supermileage/fuel-cell-control/README.md

# Fuel-Cell-Control
Fuel Cell Control Stuff
