supermileage/fuel-cell-control/pcb/fuel-cell-control/fuelCellControl/fuelCellControl.kicad_pcb

## KiCad design pcb/fuel-cell-control/fuelCellControl/fuelCellControl.kicad_pcb (2021-12-18)

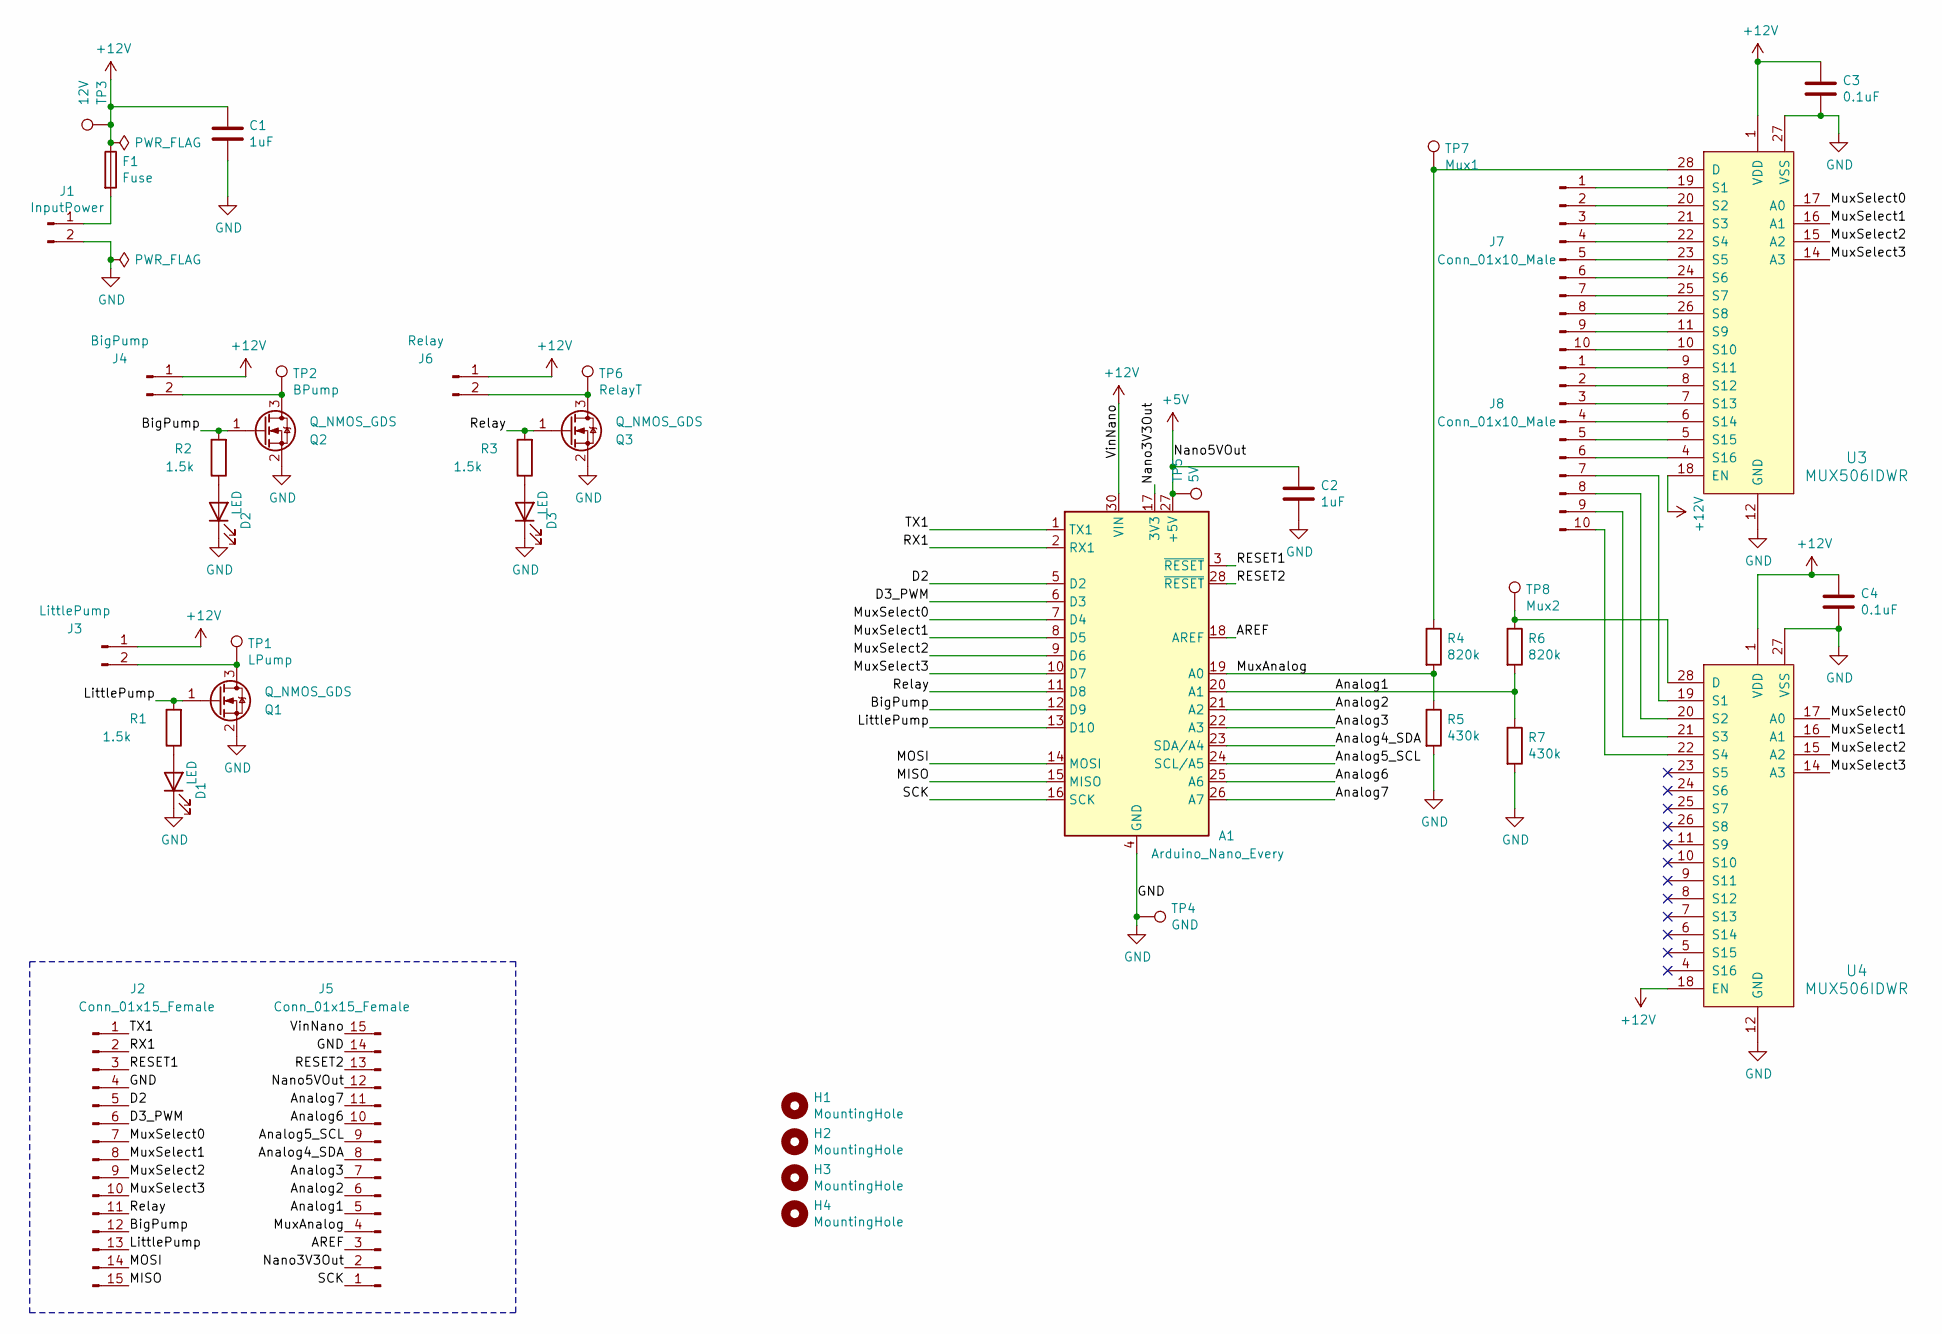
[picture p1: schematic fuelCellControl.sch]

Parts:
A1: Arduino_Nano_Every; Arduino_Nano; DigikeyPN 1050-ABX00028-ND
C1, C2: 1uF; C_0603_1608Metric; DigikeyPN 490-12330-1-ND
C3, C4: 0.1uF; C_0603_1608Metric; DigikeyPN 311-1343-1-ND
D1, D2, D3: LED; LED_0603_1608Metric; DigikeyPN SML-D12W8WT86ACT-ND
F1: Fuse; 3586KTR; DigikeyPN 36-3586KCT-ND
H1, H2, H3, H4: MountingHole; MountingHole_3.2mm_M3
J1: InputPower; Molex_Mini-Fit_Jr_5569-02A2_2x01_P4.20mm_Horizontal; DigikeyPN 0050361758-ND
J2, J5: Conn_01x15_Female; PinSocket_1x15_P2.54mm_Vertical; MPN 310-87-115-41-001101; DigikeyPN 1212-1103-ND
J3: LittlePump; Molex_Mini-Fit_Jr_5569-02A2_2x01_P4.20mm_Horizontal; DigikeyPN 0050361758-ND
J4: BigPump; Molex_Mini-Fit_Jr_5569-02A2_2x01_P4.20mm_Horizontal; DigikeyPN 0050361758-ND
J6: Relay; Molex_Mini-Fit_Jr_5569-02A2_2x01_P4.20mm_Horizontal; DigikeyPN 0050361758-ND
J7, J8: Conn_01x10_Male; PhoenixContact_MCV_1,5_10-G-3.5_1x10_P3.50mm_Vertical; DigikeyPN 277-5774-ND
Q1, Q2, Q3: Q_NMOS_GDS; SOT-89-3; DigikeyPN DMN2004WKDICT-ND
R1, R2, R3: 1.5k; R_0603_1608Metric; DigikeyPN A121524CT-ND
R4, R6: 820k; R_0603_1608Metric; DigikeyPN 311-820KHRCT-ND
R5, R7: 430k; R_0603_1608Metric; MPN RMCF0603FT430K; DigikeyPN ‎RMCF0603FT430KCT-ND‎
TP1: LPump; PinSocket_1x01_P2.54mm_Vertical
TP2: BPump; PinSocket_1x01_P2.54mm_Vertical
TP3: 12V; PinSocket_1x01_P2.54mm_Vertical
TP4: GND; PinSocket_1x01_P2.54mm_Vertical
TP5: 5V; PinSocket_1x01_P2.54mm_Vertical
TP6: RelayT; PinSocket_1x01_P2.54mm_Vertical
TP7: Mux1; PinSocket_1x01_P2.54mm_Vertical
TP8: Mux2; PinSocket_1x01_P2.54mm_Vertical
U3, U4: MUX506IDWR; SOIC-28_W7.5mm; MPN MUX506IDWR; DigikeyPN 296-47544-1-ND

Connections:
+5V: A1.27 (+5V), C2.1, J5.12, TP5.1
+12V: A1.30 (VIN), C1.1, C3.1, C4.1, F1.1, J3.1, J4.1, J5.15, J6.1, TP3.1, U3.1 (VDD), U3.18 (EN), U4.1 (VDD), U4.18 (EN)
/AREF: A1.18 (AREF), J5.3
/Analog1: A1.20 (A1), J5.5, R6.2, R7.1
/Analog2: A1.21 (A2), J5.6
/Analog3: A1.22 (A3), J5.7
/Analog4_SDA: A1.23 (SDA/A4), J5.8
/Analog5_SCL: A1.24 (SCL/A5), J5.9
/Analog6: A1.25 (A6), J5.10
/Analog7: A1.26 (A7), J5.11
/BigPump: A1.12 (D9), J2.12, Q2.1 (G), R2.2
/D2: A1.5 (D2), J2.5
/D3_PWM: A1.6 (D3), J2.6
/LittlePump: A1.13 (D10), J2.13, Q1.1 (G), R1.2
/MISO: A1.15 (MISO), J2.15
/MOSI: A1.14 (MOSI), J2.14
/MuxAnalog: A1.19 (A0), J5.4, R4.2, R5.1
/MuxSelect0: A1.7 (D4), J2.7, U3.17 (A0), U4.17 (A0)
/MuxSelect1: A1.8 (D5), J2.8, U3.16 (A1), U4.16 (A1)
/MuxSelect2: A1.9 (D6), J2.9, U3.15 (A2), U4.15 (A2)
/MuxSelect3: A1.10 (D7), J2.10, U3.14 (A3), U4.14 (A3)
/Nano3V3Out: A1.17 (3V3), J5.2
/RESET1: A1.3 (~RESET), J2.3
/RESET2: A1.28 (~RESET), J5.13
/RX1: A1.2 (RX1), J2.2
/Relay: A1.11 (D8), J2.11, Q3.1 (G), R3.2
/SCK: A1.16 (SCK), J5.1
/TX1: A1.1 (TX1), J2.1
GND: A1.4 (GND), A1.29 (GND), C1.2, C2.2, C3.2, C4.2, D1.1 (K), D2.1 (K), D3.1 (K), J1.2, J2.4, J5.14, Q1.2 (S), Q2.2 (S), Q3.2 (S), R5.2, R7.2, TP4.1, U3.12 (GND), U3.27 (VSS), U4.12 (GND), U4.27 (VSS)
unnamed: D1.2 (A), R1.1
unnamed: D2.2 (A), R2.1
unnamed: D3.2 (A), R3.1
unnamed: F1.2, J1.1
unnamed: J3.2, Q1.3 (D), TP1.1
unnamed: J4.2, Q2.3 (D), TP2.1
unnamed: J6.2, Q3.3 (D), TP6.1
unnamed: J7.1, U3.19 (S1)
unnamed: J7.2, U3.20 (S2)
unnamed: J7.3, U3.21 (S3)
unnamed: J7.4, U3.22 (S4)
unnamed: J7.5, U3.23 (S5)
unnamed: J7.6, U3.24 (S6)
unnamed: J7.7, U3.25 (S7)
unnamed: J7.8, U3.26 (S8)
unnamed: J7.9, U3.11 (S9)
unnamed: J7.10, U3.10 (S10)
unnamed: J8.1, U3.9 (S11)
unnamed: J8.2, U3.8 (S12)
unnamed: J8.3, U3.7 (S13)
unnamed: J8.4, U3.6 (S14)
unnamed: J8.5, U3.5 (S15)
unnamed: J8.6, U3.4 (S16)
unnamed: J8.7, U4.19 (S1)
unnamed: J8.8, U4.20 (S2)
unnamed: J8.9, U4.21 (S3)
unnamed: J8.10, U4.22 (S4)
unnamed: R4.1, TP7.1, U3.28 (D)
unnamed: R6.1, TP8.1, U4.28 (D)

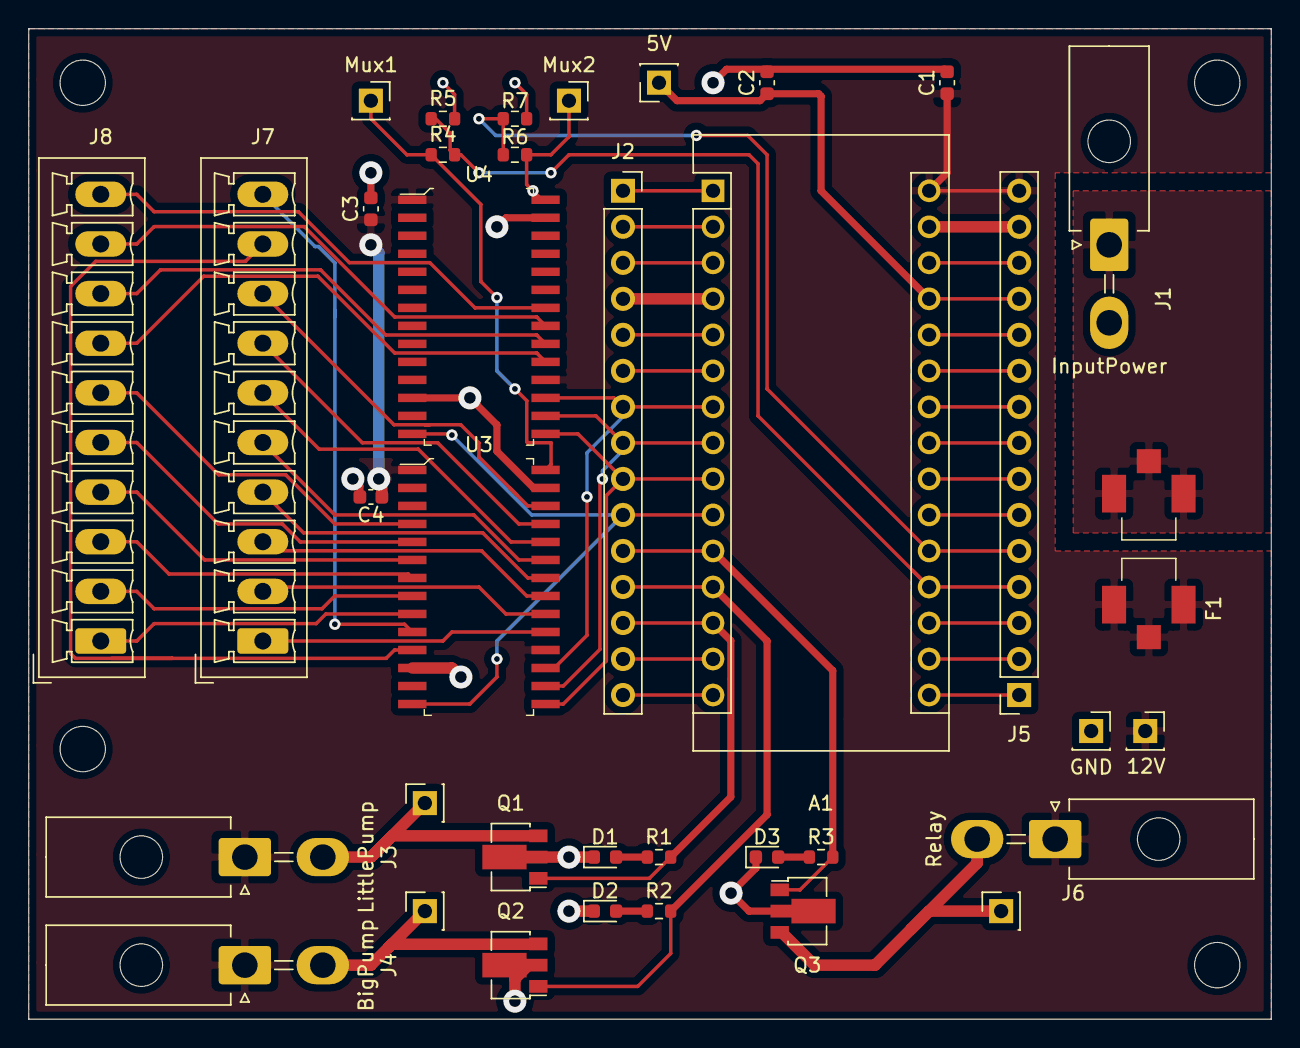
[picture p2: board fuelCellControl.kicad_pcb from above]

Board: 2 copper layers, 87.6 x 69.9 mm, 41 parts (0 on the bottom side), 58 nets.
