supermileage/fuel-cell-control/data/Calibration.xlsx

Sheet: rawval2
raw | v
0 | 0
69 | 0.995
139 | 2.003
208 | 2.994
278 | 4
347 | 4.992
418 | 5.997
488 | 7
557 | 7.99
627 | 9
697 | 9.99
766 | 10.99
837 | 12
907 | 12.99
977 | 14
1013 | 14.5

Sheet: JankSoldered
A2 | 17 | A3 |  | A4
voltage | raw | voltage |  | voltage | raw
0.995 | 65 | 0.995 | 63 | 0.995 | 65
2.994 | 192 | 2.995 | 192 | 2.995 | 193
4.992 | 322 | 4.993 | 321 | 4.993 | 322
7 | 452 | 7 | 450 | 7 | 453
9 | 582 | 9 | 580 | 9 | 582
10.99 | 712 | 10.99 | 708 | 10.99 | 711
12.99 | 841 | 12.99 | 837 | 12.99 | 841
14.99 | 970 | 14.99 | 965 | 14.99 | 970
65 | 0.995 | 63 | 0.995
192 | 2.994 | 192 | 2.995
322 | 4.992 | 321 | 4.993
452 | 7 | 450 | 7
582 | 9 | 580 | 9
712 | 10.99 | 708 | 10.99
841 | 12.99 | 837 | 12.99
970 | 14.99 | 965 | 14.99

Sheet: rawval7
rv | v
0 | 0
70 | 0.995
142 | 2.002
212 | 2.994
283 | 4
353 | 4.992
425 | 5.998
496 | 7
567 | 7.99
638 | 9
709 | 9.99
