supermileage/fuel-cell-control/(commit log)

2021-06-15 adds kicad project files
    [CD74HCT4051M.step, fuel-cell-control.kicad_pcb, fuel-cell-control.sch]
2021-06-18 Adds MUXes, DCDC Converter, and relevant libraries
    [Diodes_-_AP3502FMTR-G1.step, fuel-cell-control.sch, fuel-cell-muxes.sch]
2021-07-14 daq code
    [fuel-cell-control.sch]
2021-11-06 initial schematic
    [CD74HCT4051M.step, Diodes_-_AP3502FMTR-G1.step, fuel-cell-control.sch, fuel-cell-muxes.sch, fuelCellControl.kicad_pcb, fuelCellControl.sch]
2021-11-14 initial pcb design
    [fuelCellControl.sch]
2021-11-20 enlarged power traces
    [fuelCellControl.kicad_pcb]
2021-11-21 updated based on design review
    [fuelCellControl.kicad_pcb, fuelCellControl.sch]
2021-11-23 cleans up some longer traces
    [fuelCellControl.kicad_pcb]
2021-11-27 remove voltage regulator and update connector spacing and tracing
    [fuelCellControl.csv, fuelCellControl.kicad_pcb, fuelCellControl.sch]
2021-11-28 adds supermileage logo and updates part information
    [fuelCellControl.kicad_pcb, fuelCellControl.sch]
2021-12-18 rev1.0 schematic
    [fuelCellControl-B_Cu.gbl, fuelCellControl-B_Mask.gbs, fuelCellControl-B_Paste.gbp, fuelCellControl-B_SilkS.gbo, fuelCellControl-Edge_Cuts.gm1, fuelCellControl-F_Cu.gtl, fuelCellControl-F_Mask.gts, fuelCellControl-F_Paste.gtp]
2022-02-12 update logic, fix bug in voltage reading
    [fuelCellControl.sch]
2022-02-17 delay for mux switching and comments for changing mode in serial
2022-02-17 print error cells
2022-03-06 dyno test fixed all but highest cell
    [main_control.ino]
2022-03-11 updates to stop if stuck in init and includes cell lookup table
    [main_control.ino]
2022-03-12 serial switch and mode switch guide
2022-03-26 removes temp thing
    [fuelCellControl.csv]
2022-03-27 hydrogen sensor test and datasheets
2022-03-28 adds new analog pin readings
    [Calibration.xlsx]
2022-04-09 Adds FCP layout schematic
    [fcp-layout.kicad_pcb, fcp-layout.kicad_sch]
2022-04-11 control for potential voltage spikes
